victor7376/BTTF-World-Clock/Examples/Wiring-if-no-displays.jpg

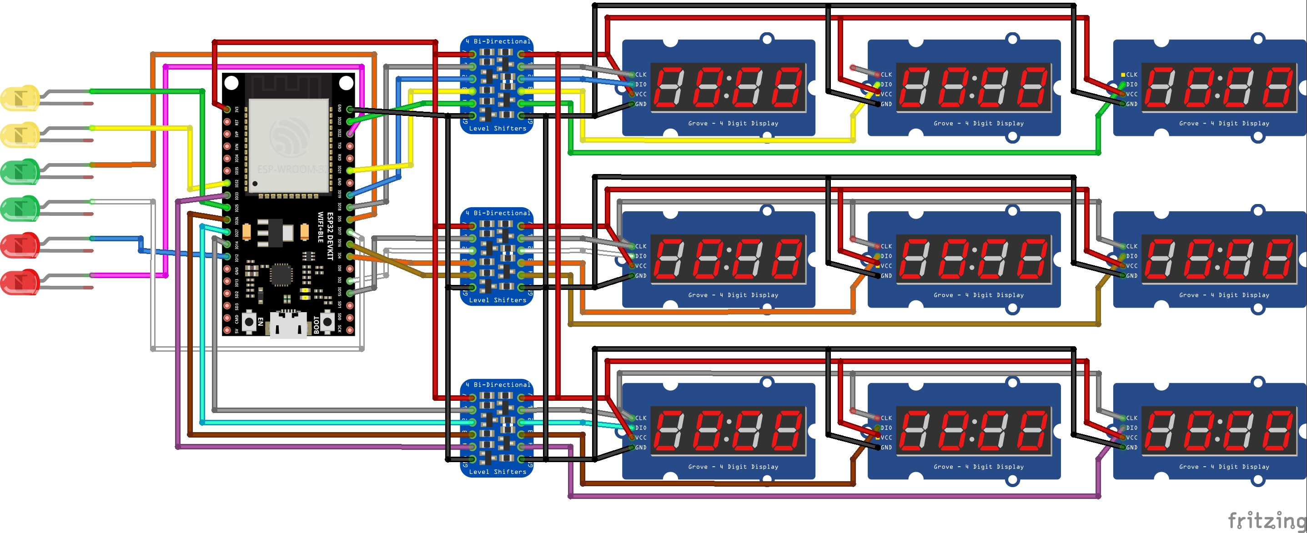
Examples/Wiring-if-no-displays.jpg
