victor7376/BTTF-World-Clock/Examples/Example-wiring.png

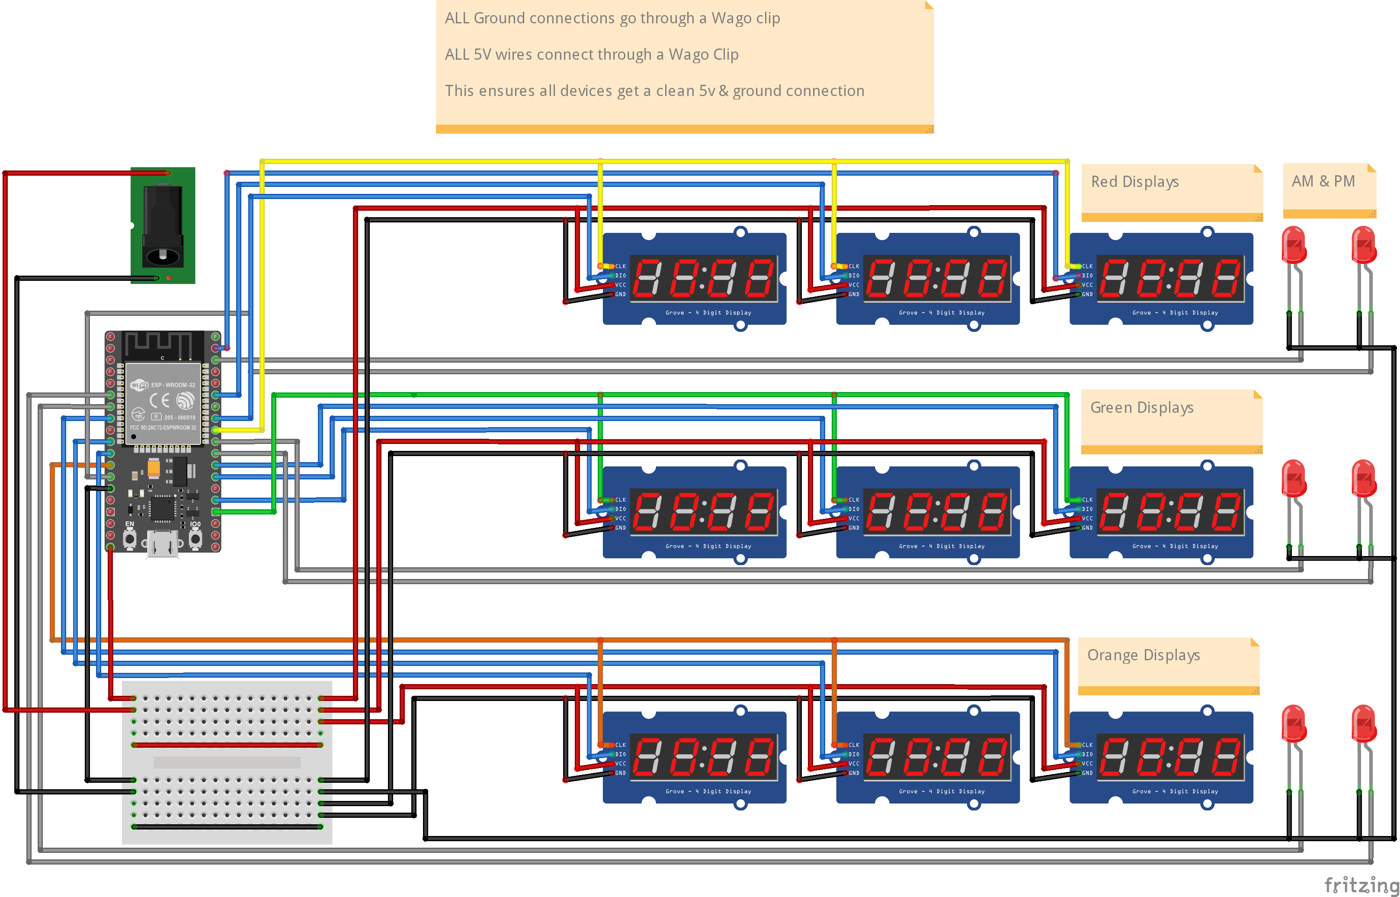
Examples/Example-wiring.png
