victor7376/BTTF-World-Clock/(commit log)

2021-02-26 Upload of the working clock 3 timezones
    Given it a full day to check the code works with the ESP32.
    Just have to make some checks on the AM & PM.
2021-03-01 Channge Orange PM pin & OTA updates
    Orange PM pin needed changing
    Added OTA updates
    Included the AM & PM feature for all timezones
2021-03-01 CHange Orange PM Pin
    Slight alteration of Orange PM pin from pin 36 to pin 25
2022-03-15 Update TimDB.cpp
    Fix error due to cloudflare
    [TimeDB.cpp]
2022-03-16 Update Clock.ino
    Removed lines which gave error to compile
    [Clock.ino]
2022-03-20 Examples of wiring
    This shows both ways of connecting the displays
